mrmaveric/PIC18F24K40-I_ML/outputs/render.png

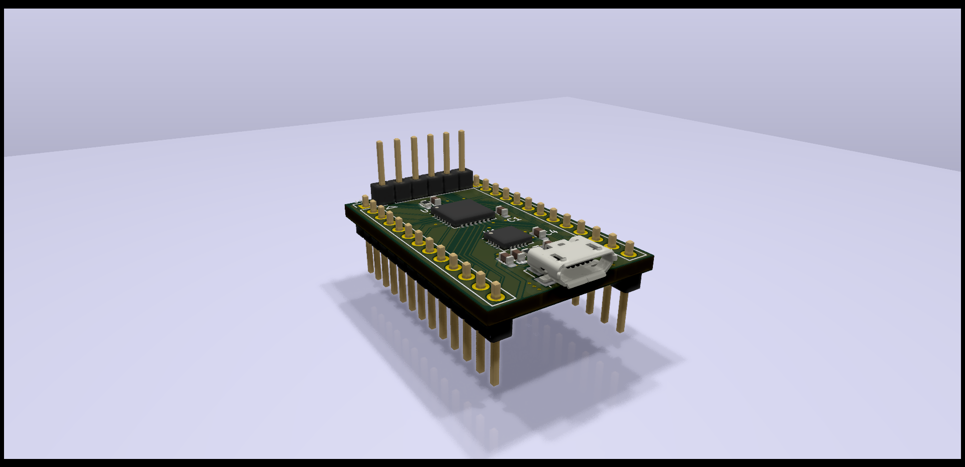
outputs/render.png
