mrmaveric/PIC18F24K40-I_ML/outputs/PCB.png

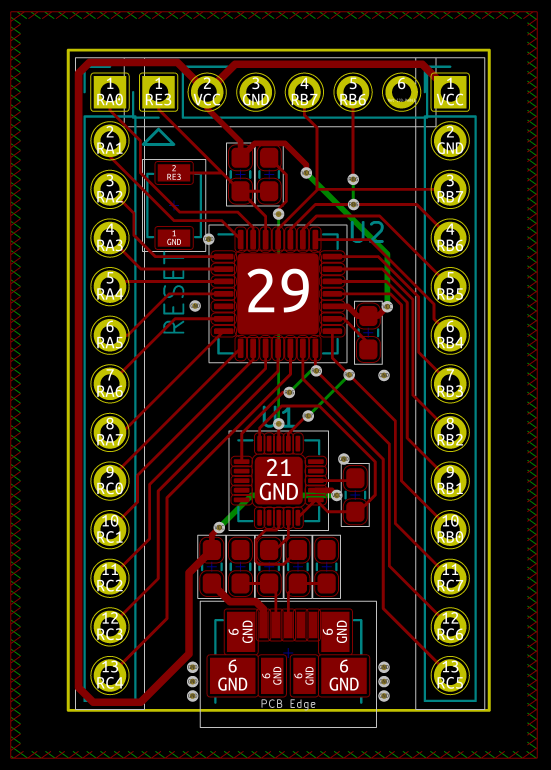
outputs/PCB.png
