mrmaveric/PIC18F24K40-I_ML/outputs/render socket.png

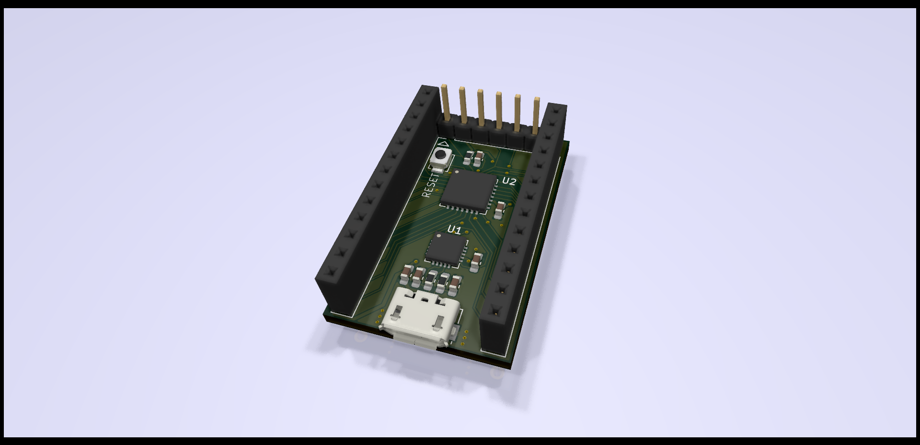
outputs/render socket.png
