mrmaveric/PIC18F24K40-I_ML/reference/QFN pinout.png

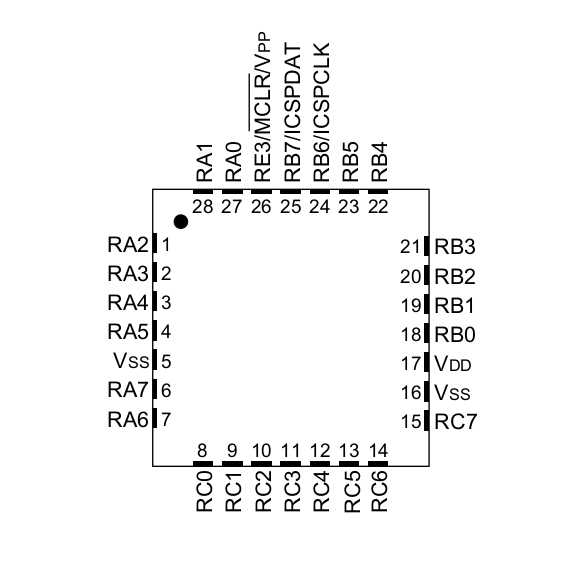
reference/QFN pinout.png
