mrmaveric/PIC18F24K40-I_ML/outputs/PIC18F24K40.pdf

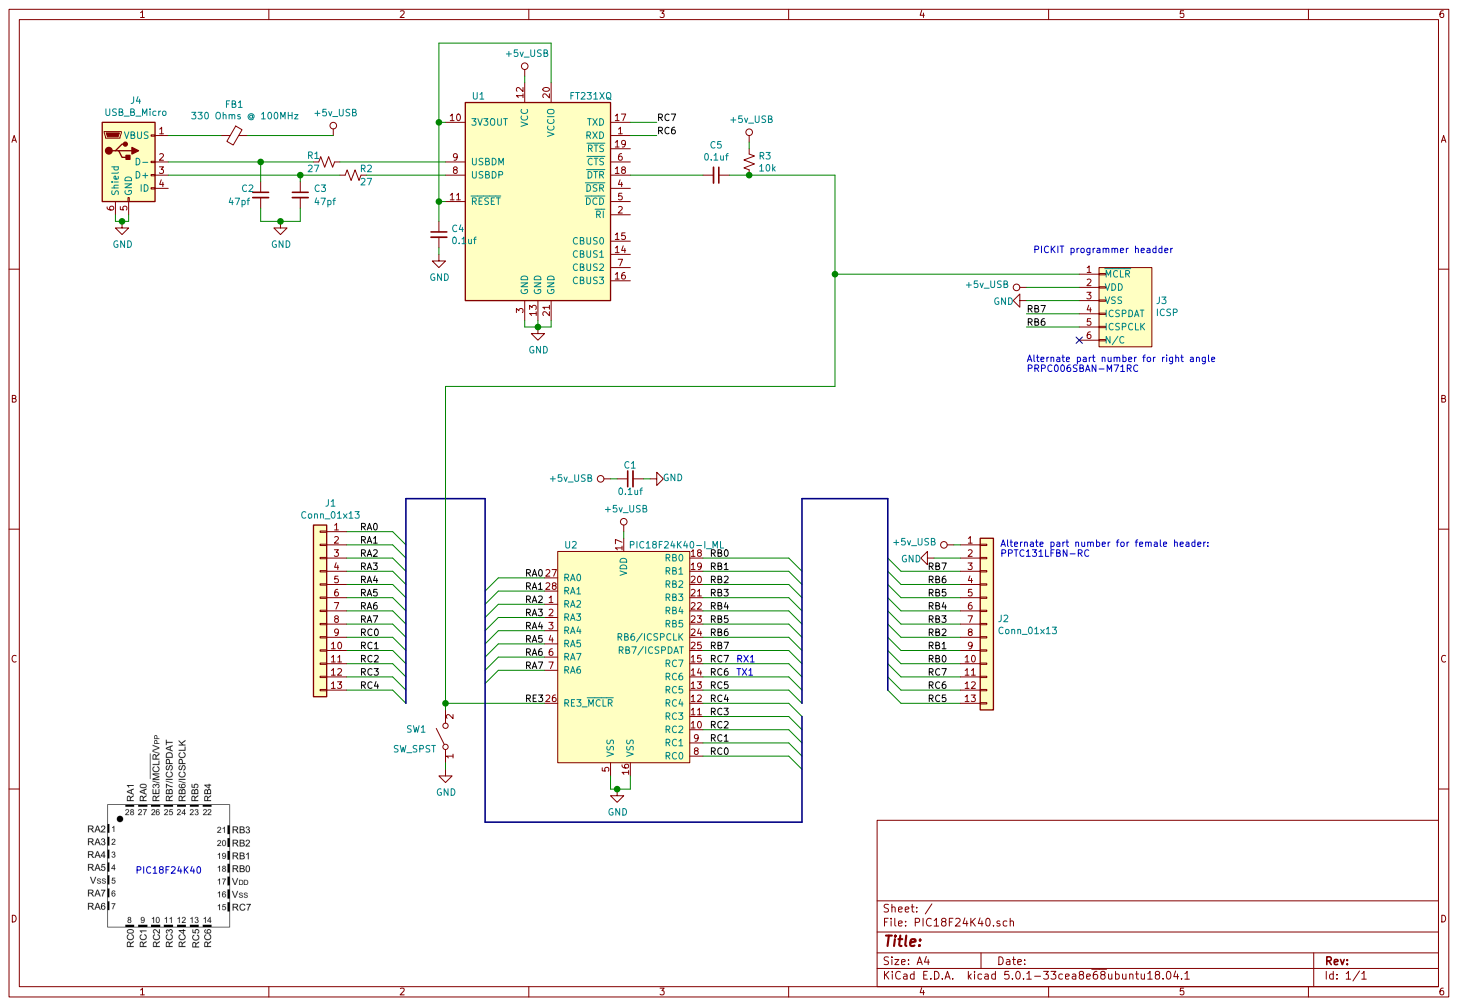
[picture p5: page 1]

3 DSR 4 DCD 5 CTS 6 CBUS2 7 USBDP 8 USBDM 9 U1 FT231XQ

Alternate part number for right angle PRPC006SBAN-M71RC
