mrmaveric/PIC18F24K40-I_ML/PIC18F24K40.kicad_pcb

## KiCad design PIC18F24K40.kicad_pcb (2018-10-31)

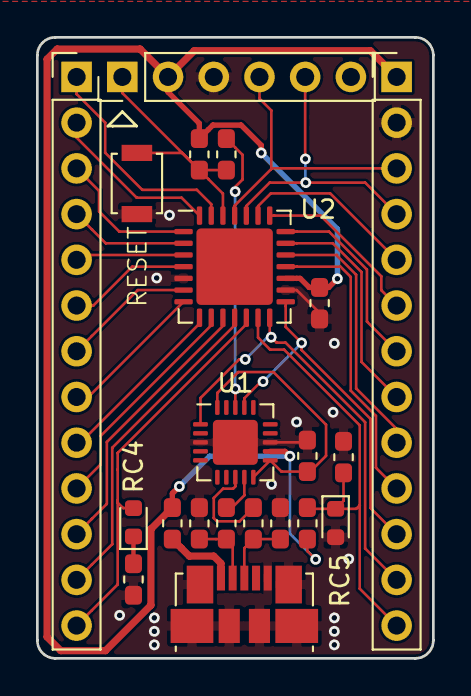
[picture p6: board PIC18F24K40.kicad_pcb from above]

Board: 2 copper layers, 22.0 x 34.5 mm, 21 parts (0 on the bottom side), 35 nets.

Parts:
C1, C4, C5: 0.1uf; C_0603_1608Metric_Pad1.05x0.95mm_HandSolder
C2, C3: 47pf; C_0603_1608Metric_Pad1.05x0.95mm_HandSolder
C6: 0.01uf; C_0603_1608Metric_Pad1.05x0.95mm_HandSolder
D1: blue; LED_0603_1608Metric
FB1: 330 Ohms @ 100MHz; C_0603_1608Metric_Pad1.05x0.95mm_HandSolder
J1, J2: Conn_01x13; PinHeader_1x13_P2.54mm_Vertical
J3: ICSP; PinHeader_1x06_P2.54mm_Vertical
J4: USB_B_Micro; USB_Micro-B_Molex_47346-0001
Q1: Q_Photo_NPN; LED_0603_1608Metric
R1, R2: 27; R_0603_1608Metric_Pad1.05x0.95mm_HandSolder
R3, R5: 10k; R_0603_1608Metric_Pad1.05x0.95mm_HandSolder
R4: 360; R_0603_1608Metric_Pad1.05x0.95mm_HandSolder
SW1: SW_SPST; SW_SPST_B3U-1000P
U1: FT231XQ; QFN-20-1EP_4x4mm_P0.5mm_EP2.5x2.5mm
U2: PIC18F24K40-I_ML; QFN-28-1EP_6x6mm_P0.65mm_EP4.25x4.25mm

Connections:
/RA0: J1.1, U2.27
/RA1: J1.2, U2.28
/RA2: J1.3, U2.1
/RA3: J1.4, U2.2
/RA4: J1.5, U2.3
/RA5: J1.6, U2.4
/RA6: J1.7, U2.6
/RA7: J1.8, U2.7
/RB0: J2.10, U2.18
/RB1: J2.9, U2.19
/RB2: J2.8, U2.20
/RB3: J2.7, U2.21
/RB4: J2.6, U2.22
/RB5: J2.5, U2.23
/RB6: J2.4, J3.5, U2.24
/RB7: J2.3, J3.4, U2.25
/RC0: J1.9, U2.8
/RC1: J1.10, U2.9
/RC2: J1.11, U2.10
/RC3: J1.12, U2.11
/RC4: D1.2, J1.13, U2.12
/RC5: C6.1, J2.13, Q1.1, R5.1, U2.13
/RC6: J2.12, U1.1, U2.14
/RC7: J2.11, U1.17, U2.15
/RE3: C5.1, J3.1, R3.2, SW1.2, U2.26
GND: C1.2, C2.2, C3.2, C4.2, C6.2, J2.2, J3.3, J4.5, J4.6, Q1.2, R4.2, SW1.1, U1.3, U1.13, U1.21, U2.5, U2.16
unnamed: C2.1, J4.2, R1.2
unnamed: C3.1, J4.3, R2.2
unnamed: C4.1, U1.10, U1.11, U1.20
unnamed: C5.2, U1.18
unnamed: D1.1, R4.1
unnamed: FB1.2, J4.1
unnamed: R1.1, U1.9
unnamed: R2.1, U1.8
VCC: C1.1, FB1.1, J2.1, J3.2, R3.1, R5.2, U1.12, U2.17
