mrmaveric/PIC18F24K40-I_ML/(commit log)

2018-10-23 Project created
    This project is an evaluation board for the PIC18F24K40
    microcontroller
    It will contain:
    - a PIC18F24K40-I/ML QFN
    - a usb connector
    - a usb FTDI chip
    - a 5V regulator for use with external power supply
    - a 2.1mm DC power jack
    - an ISCP header
    - some kind of IO breakout. Either 0.1" for every pin or arduino compatible
    [PIC18F24K40.kicad_pcb, PIC18F24K40.sch]
2018-10-23 Components added to schlib
    - voltage regulator added
    - PIC18F24K40-I_ML added
2018-10-23 Progressing through kicad setup
    PCBLIB:
    - QFN package for PIC added
    SCH:
    - Voltage regulator circuit placed
    - Package pinout image placed
    - PIC placed
    I've put down a practice bus. I think this is a good project to make use of them.
    datasheet folder renamed to reference to better match it's contents
    datasheet for voltage regulator added to reference
2018-10-23 test board layout
    I think I may want to drop the regulator
    [PIC18F24K40.sch]
2018-10-23 Regulator removed
    [PIC18F24K40.kicad_pcb, PIC18F24K40.sch]
2018-10-24 Mostly cleanup
    Backup and cache files are no longer versioned.
    I've changed the breakout headers to 13 pin from 14 as we don't need
    multiple power and ground pins broken out.
    I think this board will be much more useful if it has the ability to
    talk to a computer, so I'll be adding a part for the FTDI chip in the
    reference folder, along with a USB type ? connector.
    Currently the board is spaced to fit in a breadboard rather than
    compatible with the arduino standard.
    [PIC18F24K40.kicad_pcb, PIC18F24K40.sch]
2018-10-24 Basic layout and schematic capture
    - added decoupling cap for micro
    PCB:
    - fill on top layer removed
    - decoupling cap placed next to micro
    MODEL:
    - 1x13 header model flipped to represent the down facing orientation
    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
    [PIC18F24K40.kicad_pcb, PIC18F24K40.sch]
2018-10-24 ICSP header pin 1 visability
    [PIC18F24K40.kicad_pcb]
2018-10-24 Added a reference datasheet for a cute button
    I think I might add a couple of these as input for the board along with
    a small pot and a couple of leds for output
2018-10-24 USB and FTDI circuit added
    I've added a datasheet for usb micro connector I plan on using.
    - USB and FTDI placed with supporting passives
    - Initial layout of USB micro and FTDI chip done
    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
    [PIC18F24K40.kicad_pcb, PIC18F24K40.sch]
2018-10-25 Initial route complete
    This may be the design I get prototyped, unless I can think of anything
    I would like to change in the next few days.
    Outputs updated so the files can be viewed without kicad. Fab outputs
    will be generated and commited when I get the prototypes fabbed.
    [PIC18F24K40.kicad_pcb, PIC18F24K40.sch]
2018-10-25 Thickened up VCC track to micro
    I accidently routed the power to the micro at data trace width. Woops
    [PIC18F24K40.kicad_pcb]
2018-10-25 Updated render to show traces
    Original render didn't show the traces and my vanity couln't take it.
2018-10-25 Logo added; fab outputs generated
    I've added a test logo to the back silkscreen to see how the
    manufacturer does.
    [PIC18F24K40-B.Cu.gbr, PIC18F24K40-B.Mask.gbr, PIC18F24K40-B.SilkS.gbr, PIC18F24K40-Edge.Cuts.gbr, PIC18F24K40-F.Cu.gbr, PIC18F24K40-F.Mask.gbr, PIC18F24K40-F.SilkS.gbr, PIC18F24K40-NPTH.drl]
2018-10-26 Ordering information added to schematic elements
    Manufacturer and part number added.
    [PIC18F24K40.sch]
2018-10-26 Option for using sockets
    Part numbers and models for female connections added
    [PIC18F24K40.kicad_pcb, PIC18F24K40.sch]
2018-10-26 Reset button added Designators hidden
    [PIC18F24K40.kicad_pcb, PIC18F24K40.sch]
2018-10-26 Renders and fab outputs updated
    [PIC18F24K40-B.Cu.gbr, PIC18F24K40-B.Mask.gbr, PIC18F24K40-B.SilkS.gbr, PIC18F24K40-Edge.Cuts.gbr, PIC18F24K40-F.Cu.gbr, PIC18F24K40-F.Mask.gbr, PIC18F24K40-F.SilkS.gbr, PIC18F24K40-NPTH.drl]
2018-10-26 Ordering details added for push button
    [PIC18F24K40.sch]
2018-10-26 PCB corners rounded to look pretty
    [PIC18F24K40.kicad_pcb]
2018-10-28 LED and phototransistor added
    I've added an LED for output and phototransistor for input. No button
    though.
    [PIC18F24K40.kicad_pcb, PIC18F24K40.sch]
2018-10-28 Labels added to LED/Photo transistor
    [PIC18F24K40.kicad_pcb]
2018-10-29 Board sent to printer JLCPCB-W20181029138130
    [PIC18F24K40-B.Cu.gbr, PIC18F24K40-B.Mask.gbr, PIC18F24K40-B.SilkS.gbr, PIC18F24K40-Edge.Cuts.gbr, PIC18F24K40-F.Cu.gbr, PIC18F24K40-F.Mask.gbr, PIC18F24K40-F.SilkS.gbr, PIC18F24K40-NPTH.drl]
2018-10-31 RC5 now connected to the right place
    OMG I screwed up the light sensor connection! The boards come in soon...
    Schematic and board updated. Will kynar the prototypes
    [PIC18F24K40.kicad_pcb, PIC18F24K40.sch]
